ddrmaster1000/Band-Light-Show/Quadline_Circuit/ReadMe.txt

The Quadline was made such that it was the bassline diagram copied 4x with the GND and 12V connected accordingly. 
Thus there is no schematic, it will say there is an error but this is not an issue.
Developed on EAGLE 8.3.1
