ddrmaster1000/Band-Light-Show/Bass_Drum_Circuit/Bass Soldiworks Parts _ STL Files/ExplodedView.PNG

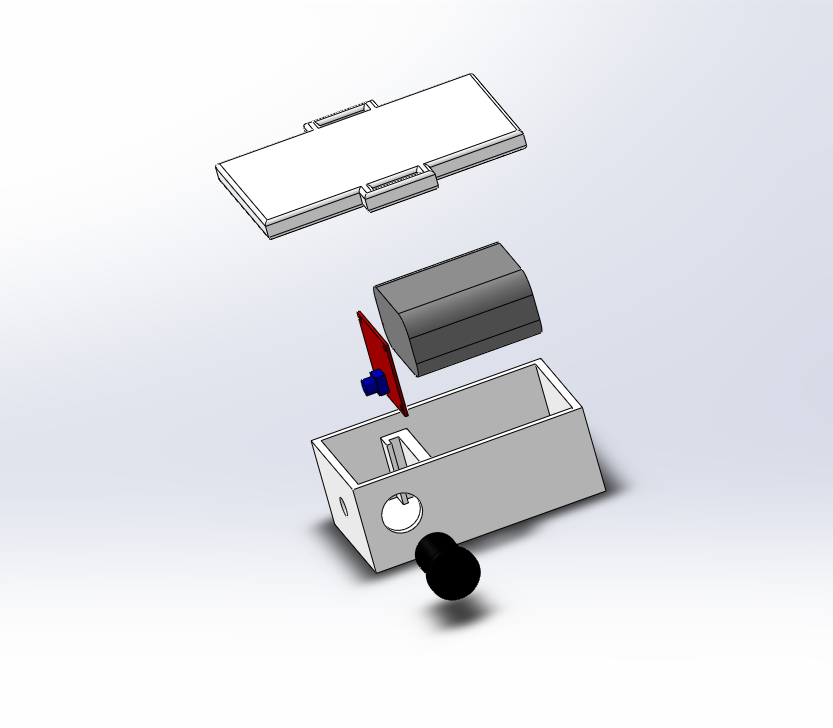
Bass_Drum_Circuit/Bass Soldiworks Parts _ STL Files/ExplodedView.PNG
