ddrmaster1000/Band-Light-Show/Quadline_Circuit/Quad Solidworks Parts _ STL Files/QuadAssembly.SLDASM

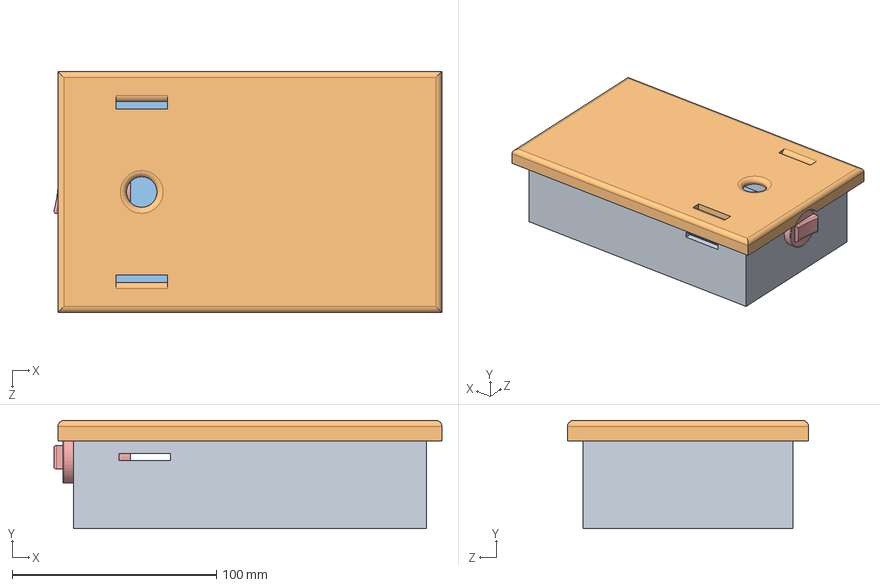
[picture p4: CAD file, 2018-03-01]
Quadline_Circuit/Quad Solidworks Parts _ STL Files/QuadAssembly.SLDASM
189.9 x 53.0 x 118.0 mm
ElectronicsHousing_QuadV2
TopCover_QuadV1
MockQuadPCB
12vBatteryPack
OnOffSwitch
