ddrmaster1000/Band-Light-Show/Bass_Drum_Circuit/Bass Soldiworks Parts _ STL Files/DrumLineAssembly.SLDASM

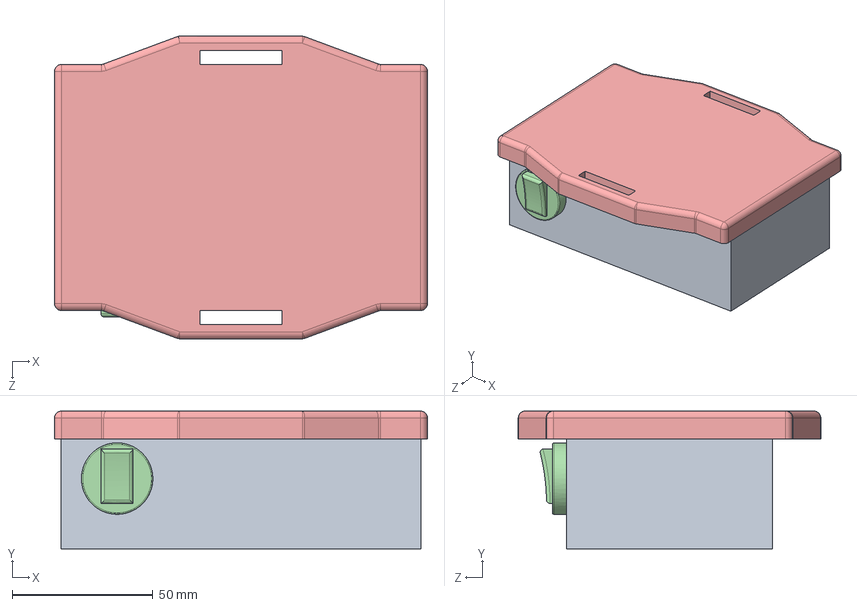
[picture p5: CAD file, 2018-03-01]
Bass_Drum_Circuit/Bass Soldiworks Parts _ STL Files/DrumLineAssembly.SLDASM
132.5 x 49.0 x 107.5 mm
ElectronicsHousingV2
12vBatteryPack
PercussionBoard
OnOffSwitch
TopCover
