ddrmaster1000/Band-Light-Show/Bass_Drum_Circuit/Bass Soldiworks Parts _ STL Files/PercussionBoard.SLDPRT

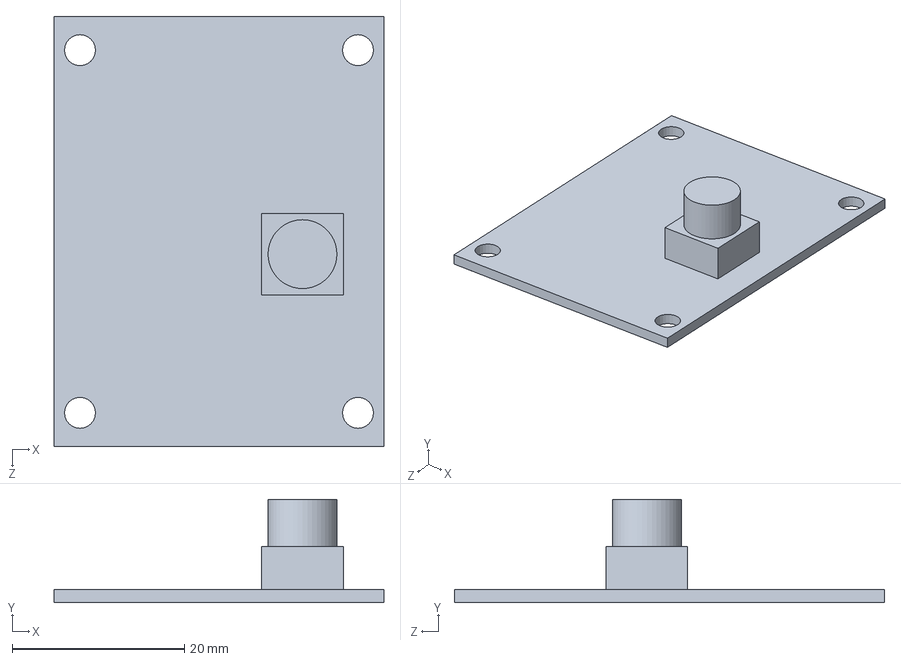
[picture p6: CAD file, 2018-03-01]
Bass_Drum_Circuit/Bass Soldiworks Parts _ STL Files/PercussionBoard.SLDPRT
38.3 x 12.0 x 50.0 mm
