ddrmaster1000/Band-Light-Show/Quadline_Circuit/Quad Solidworks Parts _ STL Files/STL files/TopCover_QuadV1.STL

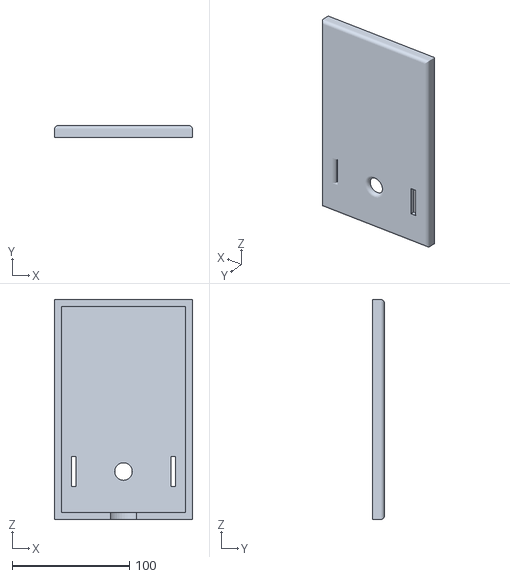
[picture p7: CAD file, 2018-03-01]
Quadline_Circuit/Quad Solidworks Parts _ STL Files/STL files/TopCover_QuadV1.STL
118.0 x 10.0 x 188.0
