ddrmaster1000/Band-Light-Show/Snare_Drums/SolidWorks/reciverboxv5.SLDPRT

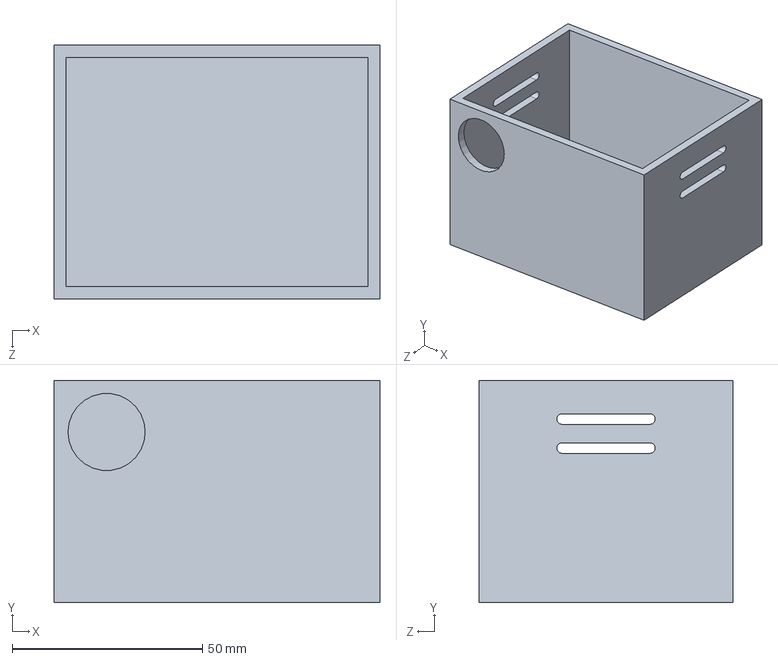
[picture p8: CAD file, 2018-03-01]
Snare_Drums/SolidWorks/reciverboxv5.SLDPRT
85.7 x 58.4 x 66.7 mm
