ddrmaster1000/Band-Light-Show/Bass_Drum_Circuit/Bass Soldiworks Parts _ STL Files/ElectricalHousingTest.SLDPRT

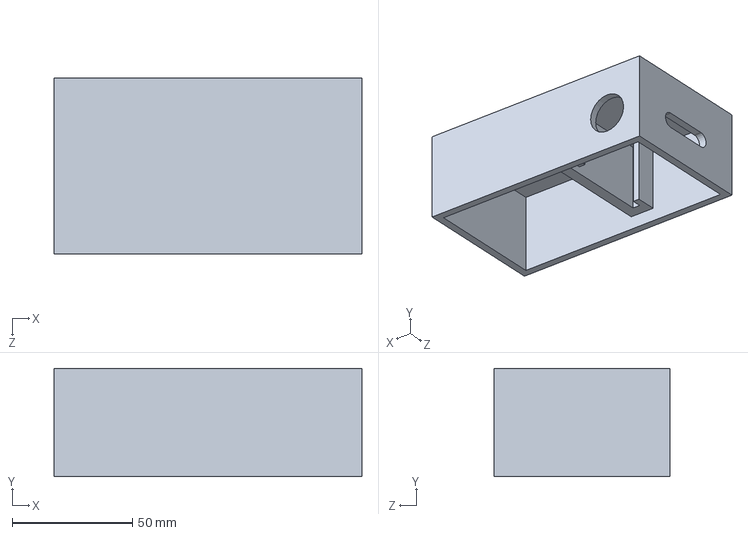
[picture p9: CAD file, 2018-03-01]
Bass_Drum_Circuit/Bass Soldiworks Parts _ STL Files/ElectricalHousingTest.SLDPRT
128.0 x 45.0 x 73.0 mm
