ddrmaster1000/Band-Light-Show/Quadline_Circuit/Quad Solidworks Parts _ STL Files/ElectronicsHousing_QuadV2.SLDPRT

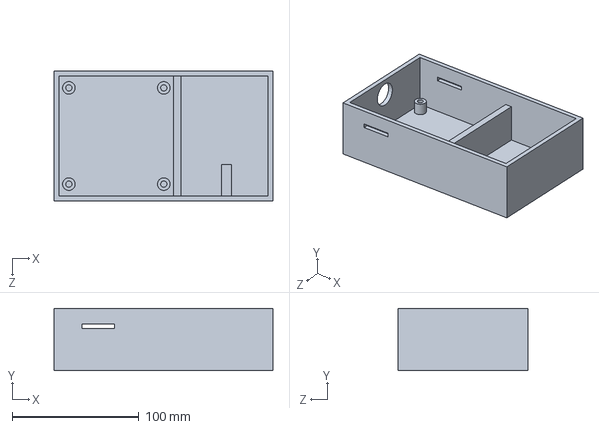
[picture p10: CAD file, 2018-03-01]
Quadline_Circuit/Quad Solidworks Parts _ STL Files/ElectronicsHousing_QuadV2.SLDPRT
173.0 x 49.0 x 103.0 mm
