ddrmaster1000/Band-Light-Show/Snare_Drums/SolidWorks/TransmitterLid.SLDPRT

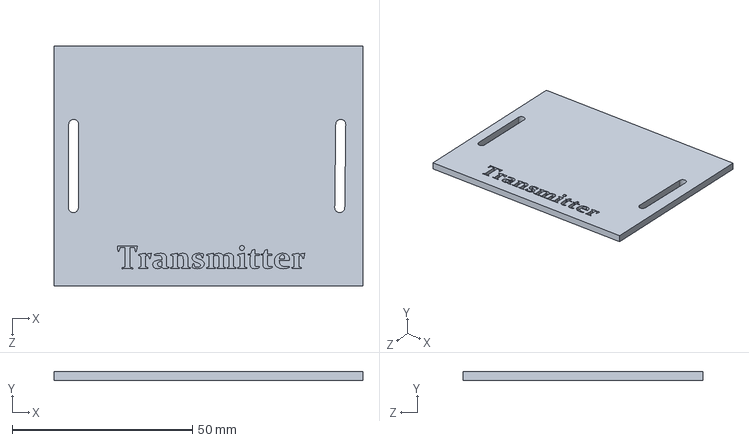
[picture p11: CAD file, 2018-03-01]
Snare_Drums/SolidWorks/TransmitterLid.SLDPRT
85.7 x 2.54 x 66.7 mm
