ddrmaster1000/Band-Light-Show/Bass_Drum_Circuit/Bass Soldiworks Parts _ STL Files/TopCoverV3.SLDPRT

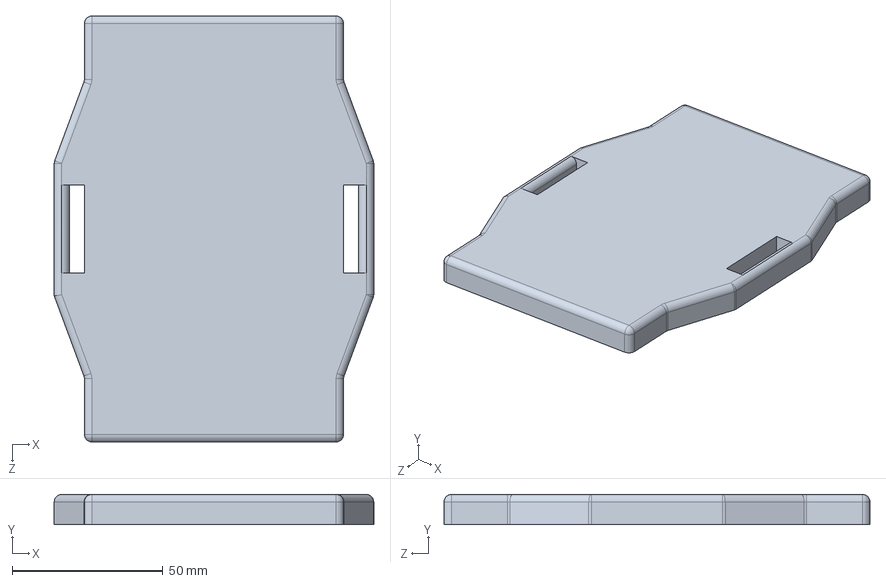
[picture p12: CAD file, 2018-03-01]
Bass_Drum_Circuit/Bass Soldiworks Parts _ STL Files/TopCoverV3.SLDPRT
106.0 x 10.0 x 141.3 mm
