ddrmaster1000/Band-Light-Show/Quadline_Circuit/Quad Solidworks Parts _ STL Files/OnOffSwitch.SLDPRT

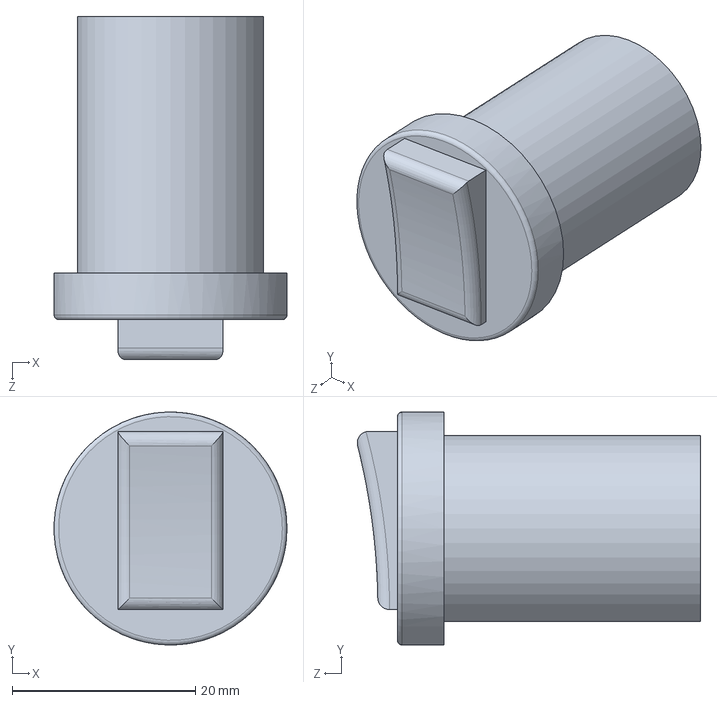
[picture p13: CAD file, 2018-03-01]
Quadline_Circuit/Quad Solidworks Parts _ STL Files/OnOffSwitch.SLDPRT
25.4 x 25.4 x 37.4 mm
