ddrmaster1000/Band-Light-Show/Quadline_Circuit/Quad Solidworks Parts _ STL Files/MockQuadPCB.SLDPRT

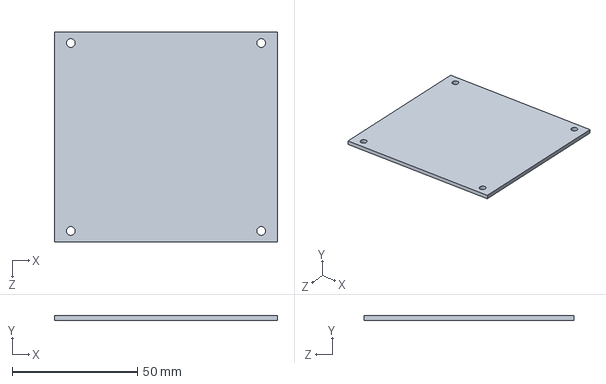
[picture p14: CAD file, 2018-03-01]
Quadline_Circuit/Quad Solidworks Parts _ STL Files/MockQuadPCB.SLDPRT
89.0 x 2.00 x 84.0 mm
