ddrmaster1000/Band-Light-Show/Snare_Drums/SolidWorks/lidv3#1.SLDPRT

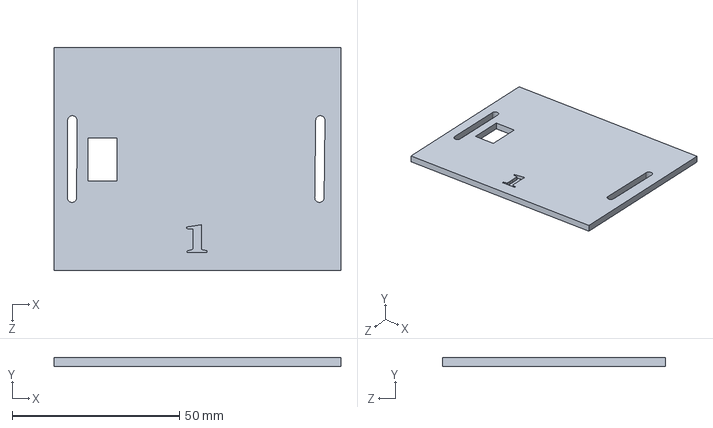
[picture p15: CAD file, 2018-03-01]
Snare_Drums/SolidWorks/lidv3#1.SLDPRT
85.7 x 2.54 x 66.7 mm
