ddrmaster1000/Band-Light-Show/Bass_Drum_Circuit/Bass Soldiworks Parts _ STL Files/12vBatteryPack.SLDPRT

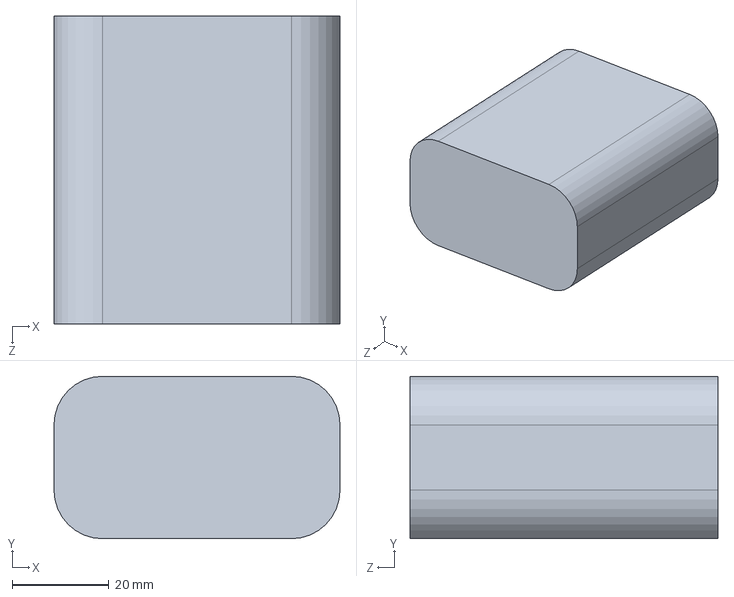
[picture p16: CAD file, 2018-03-01]
Bass_Drum_Circuit/Bass Soldiworks Parts _ STL Files/12vBatteryPack.SLDPRT
59.0 x 33.5 x 63.5 mm
