ddrmaster1000/Band-Light-Show/Bass_Drum_Circuit/Bass Soldiworks Parts _ STL Files/TopCoverV2.SLDPRT

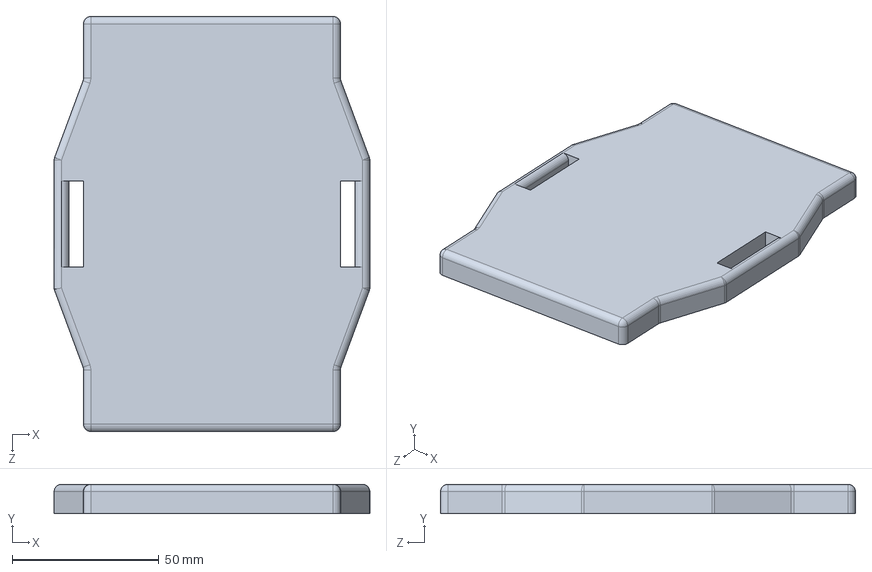
[picture p17: CAD file, 2018-03-01, an earlier design]
Bass_Drum_Circuit/Bass Soldiworks Parts _ STL Files/TopCoverV2.SLDPRT
107.5 x 10.0 x 141.3 mm
