ddrmaster1000/Band-Light-Show/(list of files, cad)

Other CAD files:
Snare_Drums/SolidWorks/Transmitter Box.SLDPRT
Bass_Drum_Circuit/Bass Soldiworks Parts _ STL Files/ElectronicsHousingV2.SLDPRT
Bass_Drum_Circuit/Bass Soldiworks Parts _ STL Files/STL files/ElectronicsHousingV2.STL
Bass_Drum_Circuit/Bass Soldiworks Parts _ STL Files/STL files/TopCoverV3.STL
Quadline_Circuit/Quad Solidworks Parts _ STL Files/STL files/ElectronicsHousing_QuadV2.STL
