ddrmaster1000/Band-Light-Show/Snare_Drums/Snare Line Shield/arduino_shield_drumline.brd

## EAGLE design Snare_Drums/Snare Line Shield/arduino_shield_drumline.brd (2018-03-01)

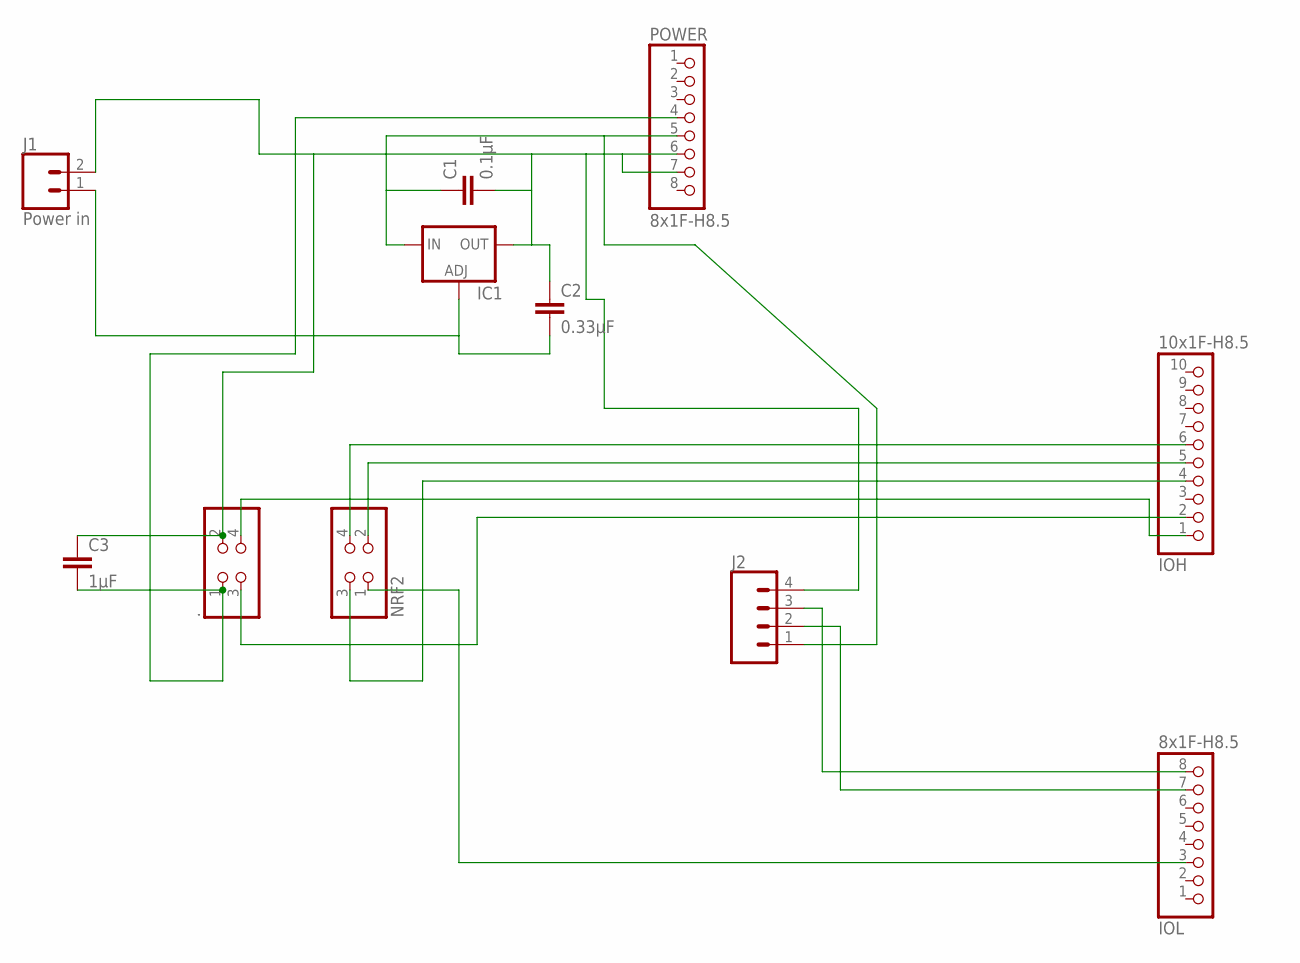
[picture p18: schematic arduino_shield_drumline.sch]

Parts:
.: PINHD-2X2; 2X02
C1: 0.1µF; 0805
C2: 0.33µF; 0805
C3: 1µF; 0805
IC1: LM138-TS; TO220S
IOH: 10x1F-H8.5; 1X10
IOL: 8x1F-H8.5; 1X08
J1: Power in; 1X02
J2: CONN_04; 1X04
NRF2: PINHD-2X2; 2X02
POWER: 8x1F-H8.5; 1X08

Connections:
GND: ..2, C1.2, C2.1, C3.1, IC1.2 (OUT), J1.2, J2.4, POWER.6, POWER.7
unnamed: ..1, C3.2, POWER.4
unnamed: IOH.5, NRF2.2
unnamed: ..4, IOH.1
unnamed: ..3, IOH.2
unnamed: IOH.6, NRF2.4
unnamed: IOL.3, NRF2.1
unnamed: IOH.4, NRF2.3
unnamed: C1.1, IC1.3 (IN), J2.1, POWER.5
unnamed: C2.2, IC1.1 (ADJ), J1.1
unnamed: IOL.8, J2.3
unnamed: IOL.7, J2.2

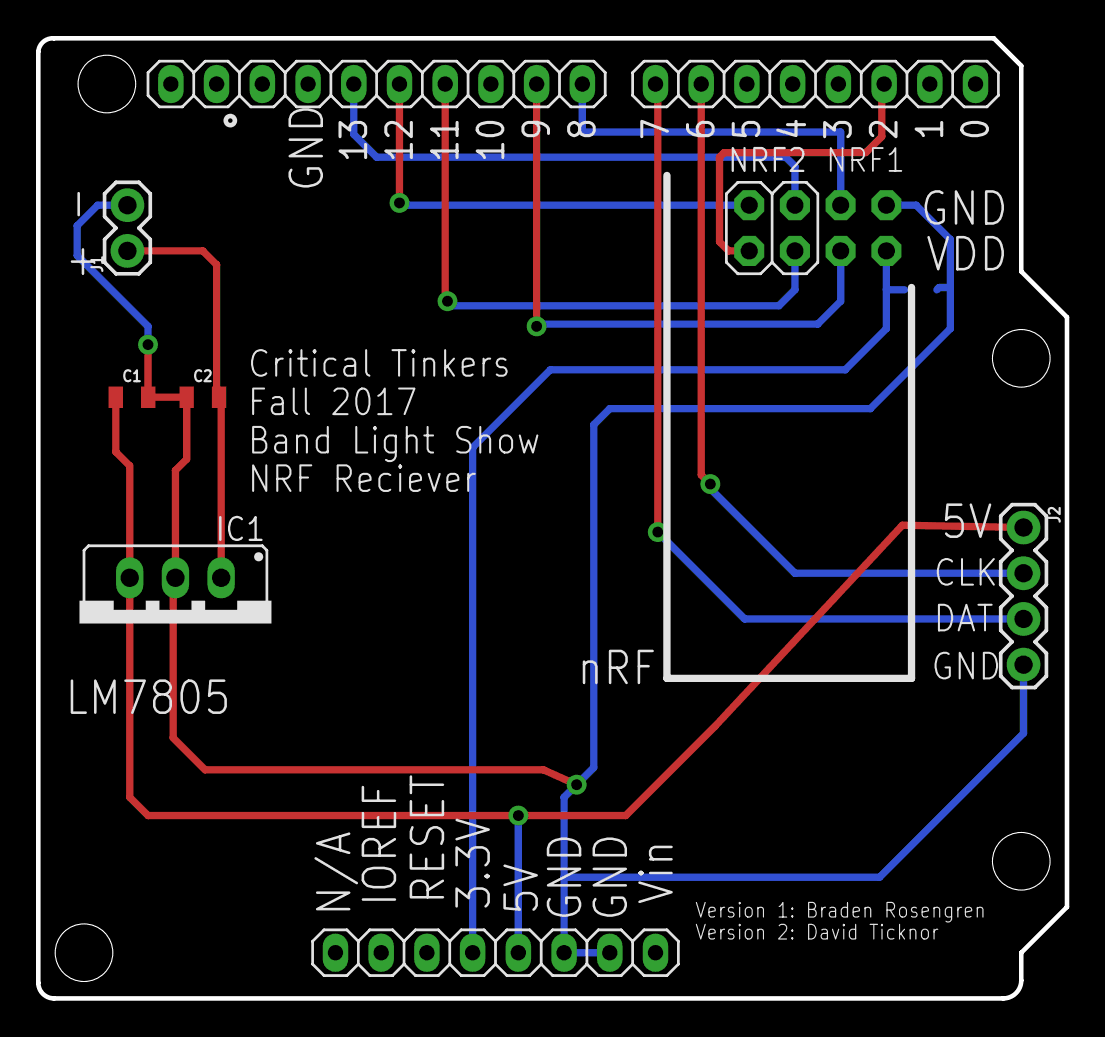
[picture p19: board arduino_shield_drumline.brd from above]

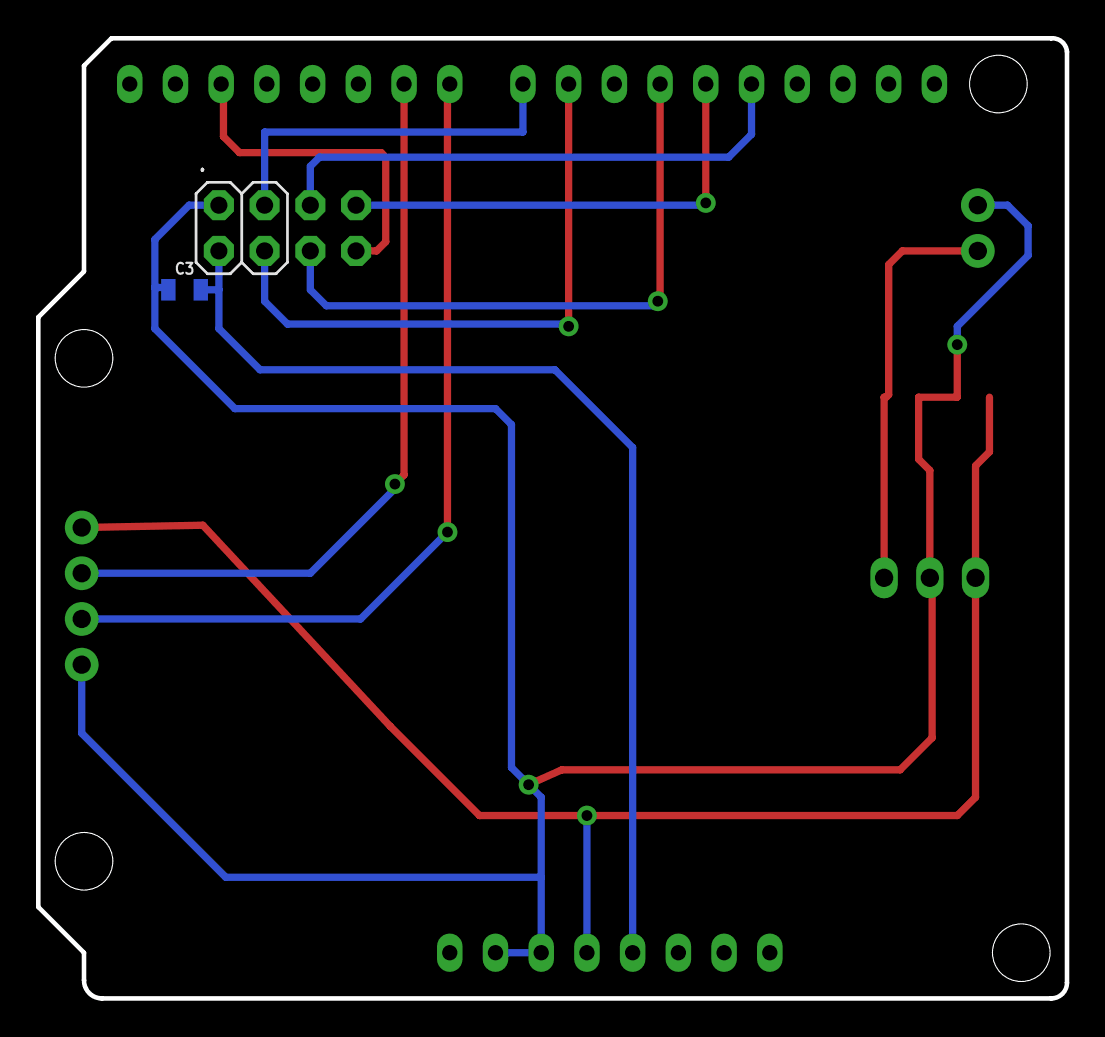
[picture p20: board arduino_shield_drumline.brd from below]

Board: 2 copper layers, 57.2 x 53.3 mm, 11 parts (2 on the bottom side), 12 nets.
