ddrmaster1000/Band-Light-Show/Quadline_Circuit/CT Quadline Quads.brd

## EAGLE design Quadline_Circuit/CT Quadline Quads.brd (2018-03-01)

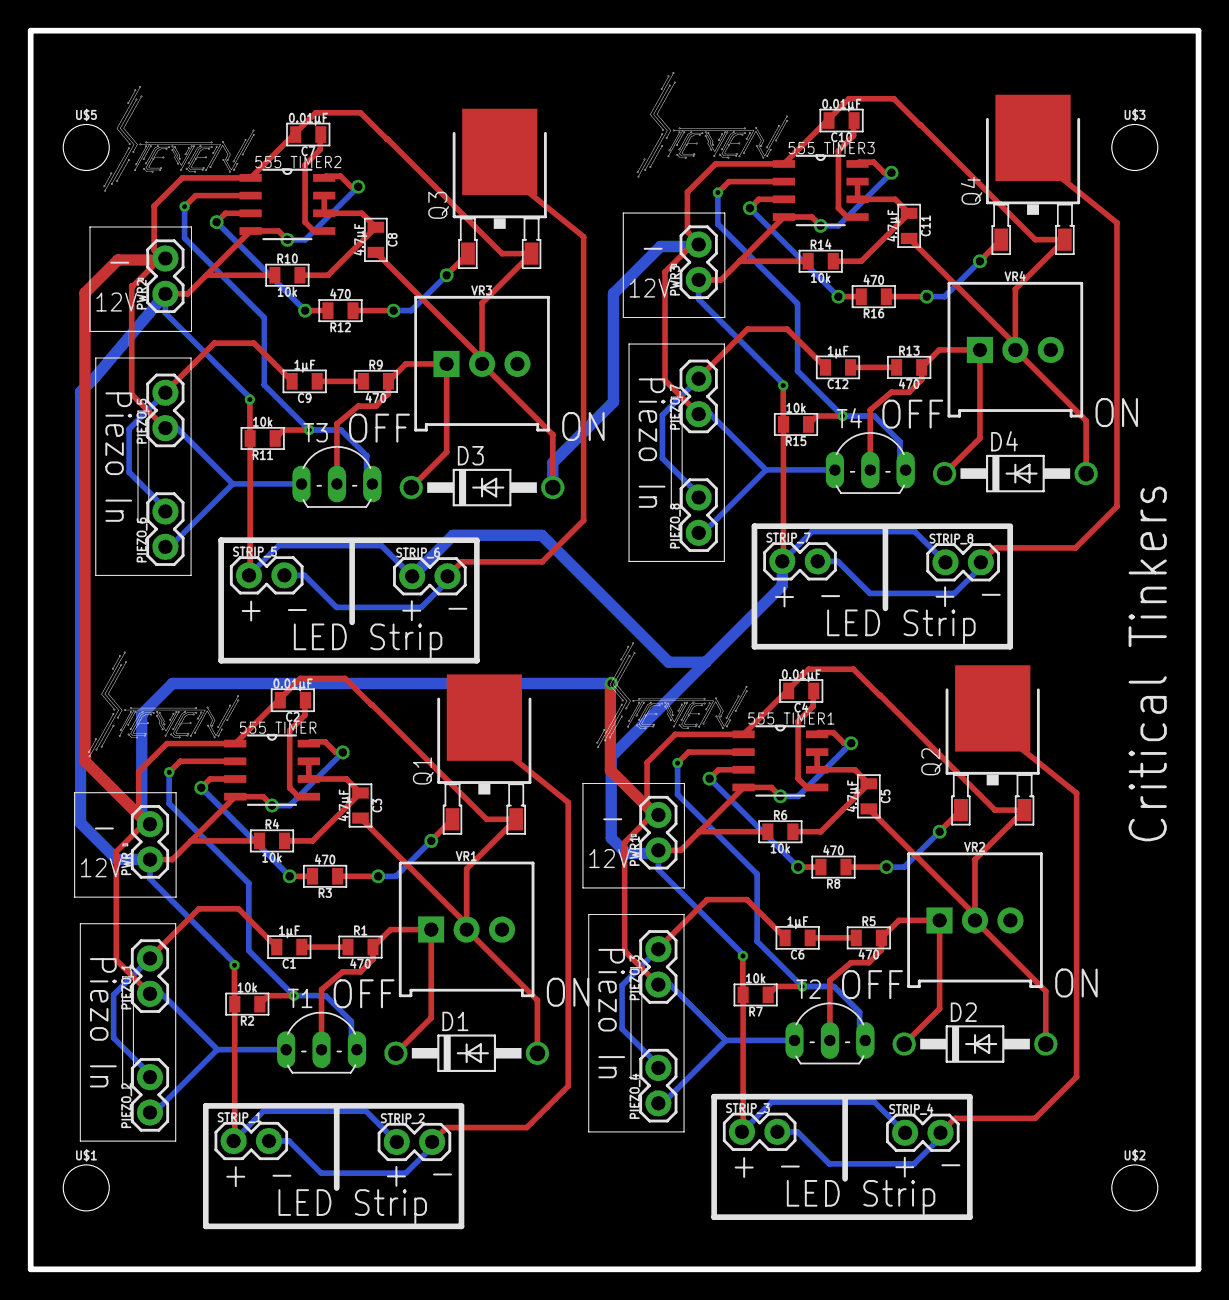
[picture p21: board CT Quadline Quads.brd from above]

Board: 2 copper layers, 83.8 x 88.9 mm, 72 parts (0 on the bottom side), 38 nets.

Parts:
555_TIMER, 555_TIMER1, 555_TIMER2, 555_TIMER3: LM555CM; SOIC127P600X175-8N
C1, C6, C9, C12: 1µF; 0805
C2, C4, C7, C10: 0.01µF; 0805
C3, C5, C8, C11: 4.7µF; 0805
D1, D2, D3, D4: 1N4006; DO41-10
PIEZO_1, PIEZO_2, PIEZO_3, PIEZO_4, PIEZO_5, PIEZO_6, PIEZO_7, PIEZO_8: 1X02
PWR, PWR1, PWR2, PWR3: 1X02
Q1, Q2, Q3, Q4: RFD14N05SM9A; TO252
R1, R3, R5, R8, R9, R12, R13, R16: 470; 0805
R2, R4, R6, R7, R10, R11, R14, R15: 10k; 0805
STRIP_1, STRIP_2, STRIP_3, STRIP_4, STRIP_5, STRIP_6, STRIP_7, STRIP_8: 1X02
T1, T2, T3, T4: 2N2222; TO92-EBC-OVAL
U$1, U$2, U$3, U$5: STAND-OFF
VR1, VR2, VR3, VR4: 10k; TRIMPOT-PTH-3386U

Connections:
12V: 555_TIMER.4, 555_TIMER.8, 555_TIMER1.4, 555_TIMER1.8, 555_TIMER2.4, 555_TIMER2.8, 555_TIMER3.4, 555_TIMER3.8, PWR.1, PWR1.1, PWR2.1, PWR3.1, R2.2, R4.1, R6.1, R7.2, R10.1, R11.2, R14.1, R15.2, STRIP_1.1, STRIP_2.1, STRIP_3.1, STRIP_4.1, STRIP_5.1, STRIP_6.1, STRIP_7.1, STRIP_8.1
GATE: Q1.1, R3.1
GATE1: Q2.1, R8.1
GATE2: Q3.1, R12.1
GATE3: Q4.1, R16.1
GND: 555_TIMER.1, 555_TIMER1.1, 555_TIMER2.1, 555_TIMER3.1, C2.2, C3.2, C4.2, C5.2, C7.2, C8.2, C10.2, C11.2, D1.A, D2.A, D3.A, D4.A, PIEZO_1.1, PIEZO_2.1, PIEZO_3.1, PIEZO_4.1, PIEZO_5.1, PIEZO_6.1, PIEZO_7.1, PIEZO_8.1, PWR.2, PWR1.2, PWR2.2, PWR3.2, Q1.2, Q2.2, Q3.2, Q4.2, T1.E, T2.E, T3.E, T4.E, VR1.2, VR2.2, VR3.2, VR4.2
unnamed: C1.1, R1.1
unnamed: C6.2, PIEZO_3.2, PIEZO_4.2
unnamed: 555_TIMER.3, R3.2
unnamed: 555_TIMER.5, C2.1
unnamed: C1.2, PIEZO_1.2, PIEZO_2.2
unnamed: 555_TIMER1.5, C4.1
unnamed: 555_TIMER1.6, 555_TIMER1.7, C5.1, R6.2
unnamed: 555_TIMER.6, 555_TIMER.7, C3.1, R4.2
unnamed: C6.1, R5.1
unnamed: 555_TIMER1.3, R8.2
unnamed: C9.2, PIEZO_5.2, PIEZO_6.2
unnamed: 555_TIMER2.5, C7.1
unnamed: 555_TIMER2.6, 555_TIMER2.7, C8.1, R10.2
unnamed: C9.1, R9.1
unnamed: 555_TIMER2.3, R12.2
unnamed: C12.2, PIEZO_7.2, PIEZO_8.2
unnamed: 555_TIMER3.5, C10.1
unnamed: 555_TIMER3.6, 555_TIMER3.7, C11.1, R14.2
unnamed: C12.1, R13.1
unnamed: 555_TIMER3.3, R16.2
NO_CONNECT_TO_TRIGGER: D1.C, R1.2, T1.B, VR1.1
NO_CONNECT_TO_TRIGGER1: D2.C, R5.2, T2.B, VR2.1
NO_CONNECT_TO_TRIGGER2: D3.C, R9.2, T3.B, VR3.1
NO_CONNECT_TO_TRIGGER3: D4.C, R13.2, T4.B, VR4.1
STRIP_GND_0: Q1.3, STRIP_1.2, STRIP_2.2
STRIP_GND_1: Q2.3, STRIP_3.2, STRIP_4.2
STRIP_GND_2: Q3.3, STRIP_5.2, STRIP_6.2
STRIP_GND_3: Q4.3, STRIP_7.2, STRIP_8.2
TRIGGER: 555_TIMER.2, R2.1, T1.C
TRIGGER1: 555_TIMER1.2, R7.1, T2.C
TRIGGER2: 555_TIMER2.2, R11.1, T3.C
TRIGGER3: 555_TIMER3.2, R15.1, T4.C
