ddrmaster1000/Band-Light-Show/(commit log)

2018-03-01 First Upload
    Includes Bass Drum and Quad Drum Eagle files + STL files for enclosures. Does not include the Snare drum code, hardware, or parts list at this time. use parts list as a guide, it is not perfect.
    [12vBatteryPack.SLDPRT, CT Bassline 3.0.brd, CT Bassline 3.0.sch, CT Quadline Quads.brd, CT Quadline Quads.sch, DrumLineAssembly.SLDASM, ElectricalHousingTest.SLDPRT, ElectronicsHousingV2.SLDPRT]
2018-03-01 Snare Line Code
    Added Snare Line code from David & Steve
    [Transmitter Box.SLDPRT, TransmitterLid.SLDPRT, arduino_shield_drumline.brd, arduino_shield_drumline.sch, lidv3#1.SLDPRT, reciverboxv5.SLDPRT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]
2018-03-31 EE 333 Notes
    Uploaded a base schematic, parts, and info
